openradiation/openradiation-hardware-kitV2/Kit_assemble.jpg

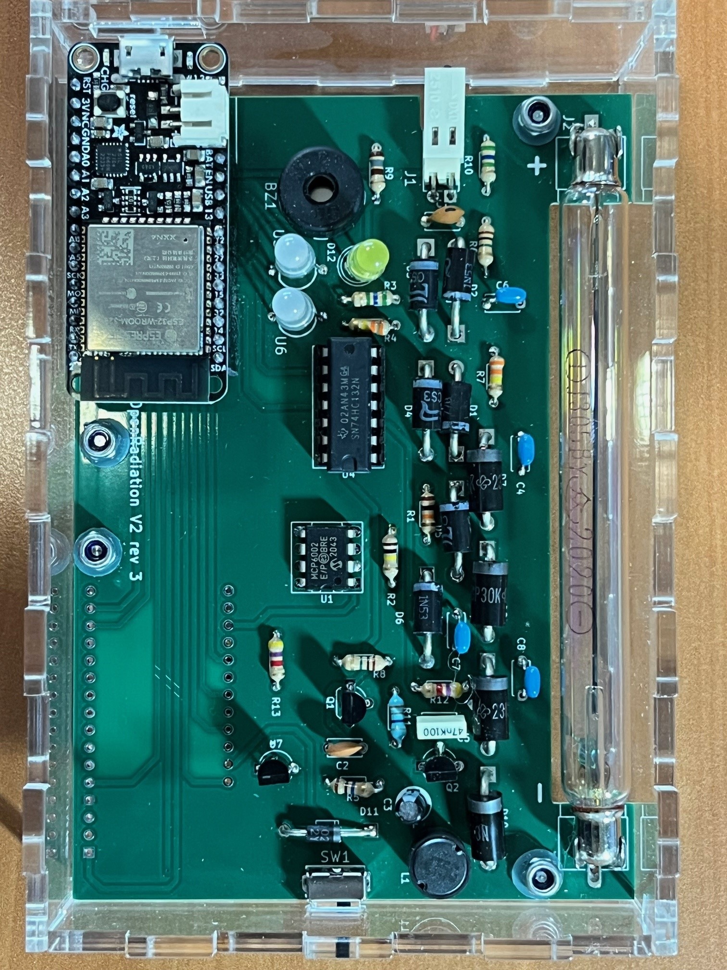
Kit_assemble.jpg
