openradiation/openradiation-hardware-kitV2/README.md

# openradiation-hardware-kitV2

All documents are under CC-BY-SA openradiation.org Licence
