openradiation/openradiation-hardware-kitV2/Components_List.xlsx

Reference | Description | Quantity | Comments
R1 | Resistor 10 KOhms 5% 1/4W | 1
R2 | Resistor 100 KOhms 5% 1/4W | 1
R9 | Resistor 180 Ohms 5% 1/4W | 1
R12, R13 | Resistor 4,7KOhms 5% 1/4W | 2
R4, R7 | Resistor 330 KOhms 5% 1/4W | 2
R6, R8 | Resistor 1 MOhms 5% 1/4W | 2
R3,R10 | Resistor 5,6 MOhms 5% 1/4W | 2
R5 | Résistance 10 MOhms 5% 1/4W | 1
R11 | Resistor 33 MOhms 5% 1/4W | 1
C1 | Condensator 47pF 500V | 1
C2 | Condensator 12pF 100V | 1
C3 | Condensator 1µF 50V | 1
C5 | Condensator 47nF 50V | 1
C4, C6, C7, C8 | Condensator 10nF/630V | 4 | RDER72J103K2M1H03A
D7, D8, D9, D10 | RGP15M-E3/73 | 4
D1, D2, D3, D4, D5, D6 | 1N5377 | 6
D11 | UF4002 | 1
D12 | Yellow Led Diam 5mm | 1
Q1 | MPSA42 | 1
Q2 | BC337 | 1
U1 | MCP6002 | 1
U2 | Feather Huzzah Board ESP32 ADA3405 | 1
U4 | 74HC132 | 1
U5, U6 | Neo-Pixel Led Diam 5mm | 1
U7 | DS18B20+ | 1
L1 | Inductor 4,7 mH +/-10% | 1 | 13R475C
J1 | 2 Pin Header 2.54mm | 1 | NSK254-2C
SW1 | Slide Switch | 1 | OS102011MA1QN1
BZ1 | Buzzer | 1 | PKHPS0013E4000-A2
J2 | Fuse Holder | 2
