openradiation/openradiation-hardware-kitV2/Schéma_électronique_carte_OpenRadiationV2-V20220321.pdf

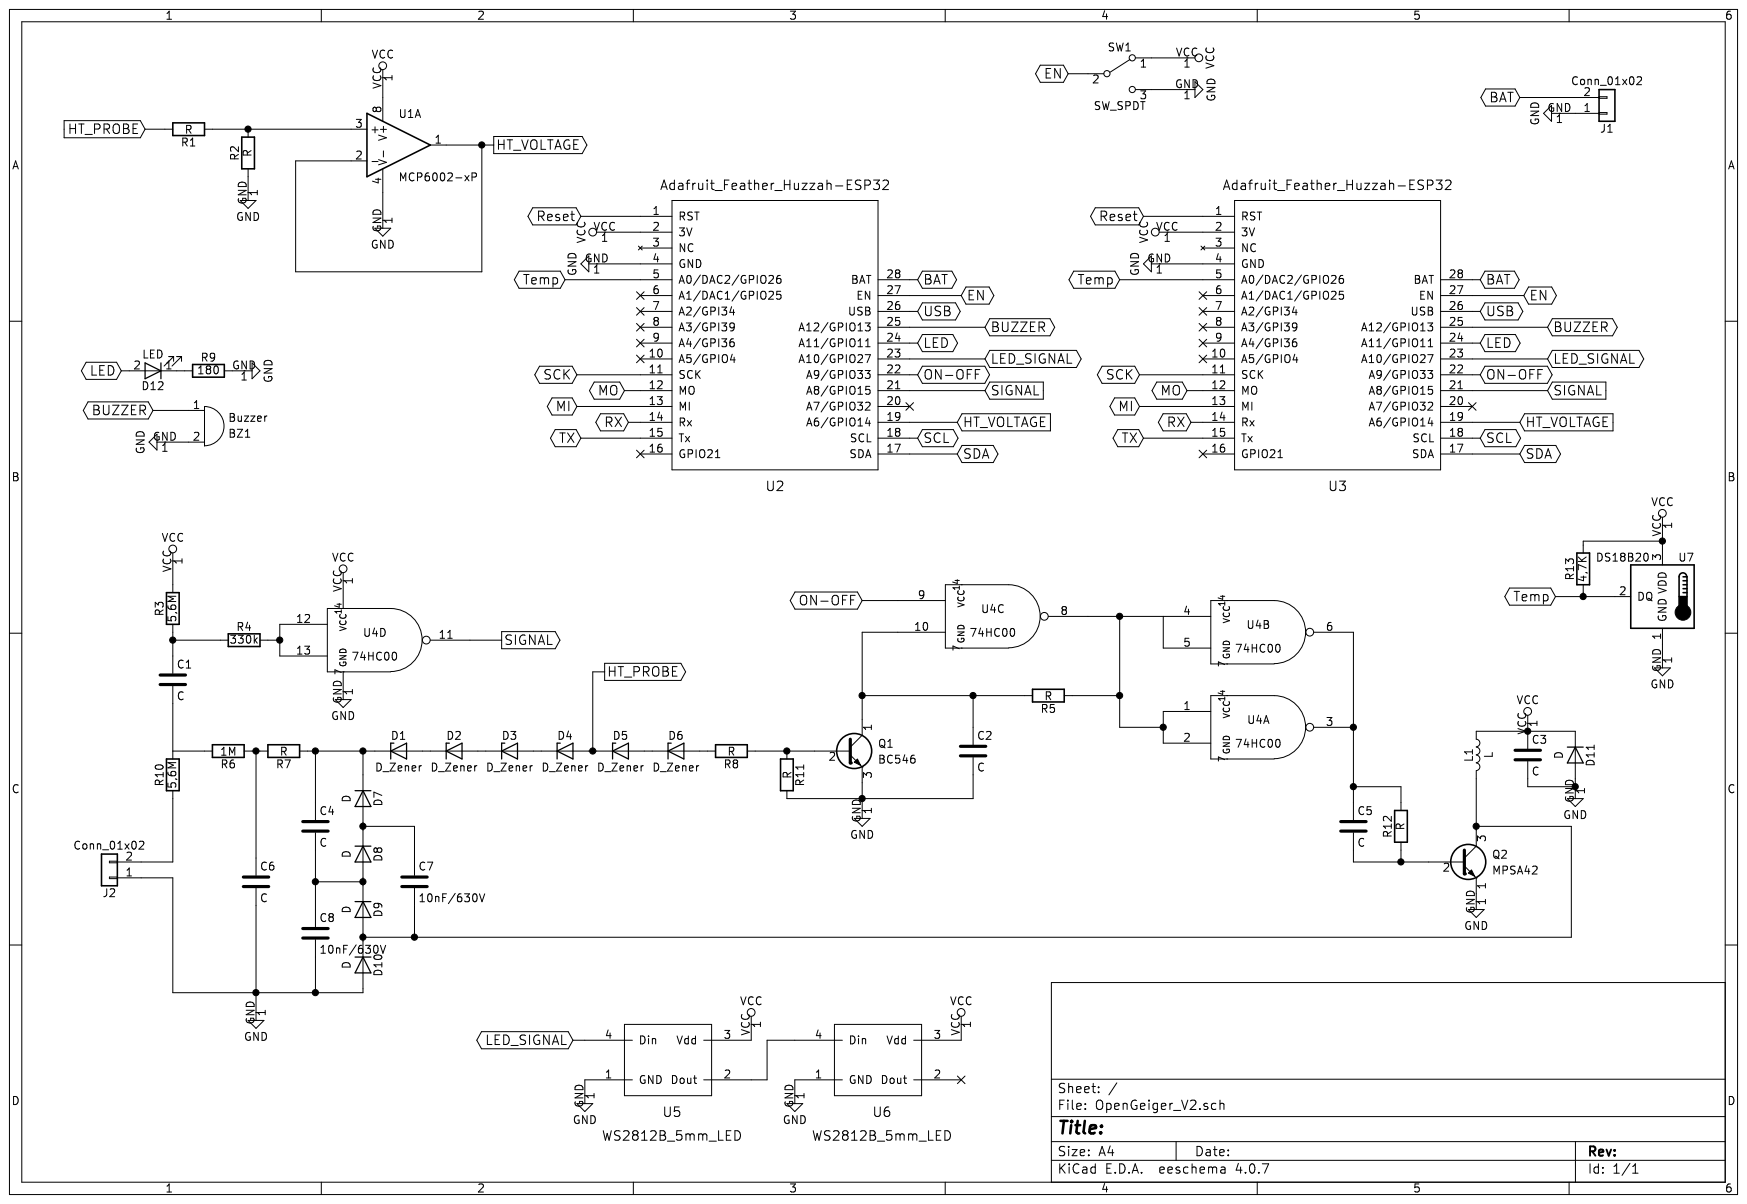
[picture p16: page 1]
